Omniasherief/AUTONOMOUS_SUMO_ROBOT/code/msg1408082404-21119.jpg

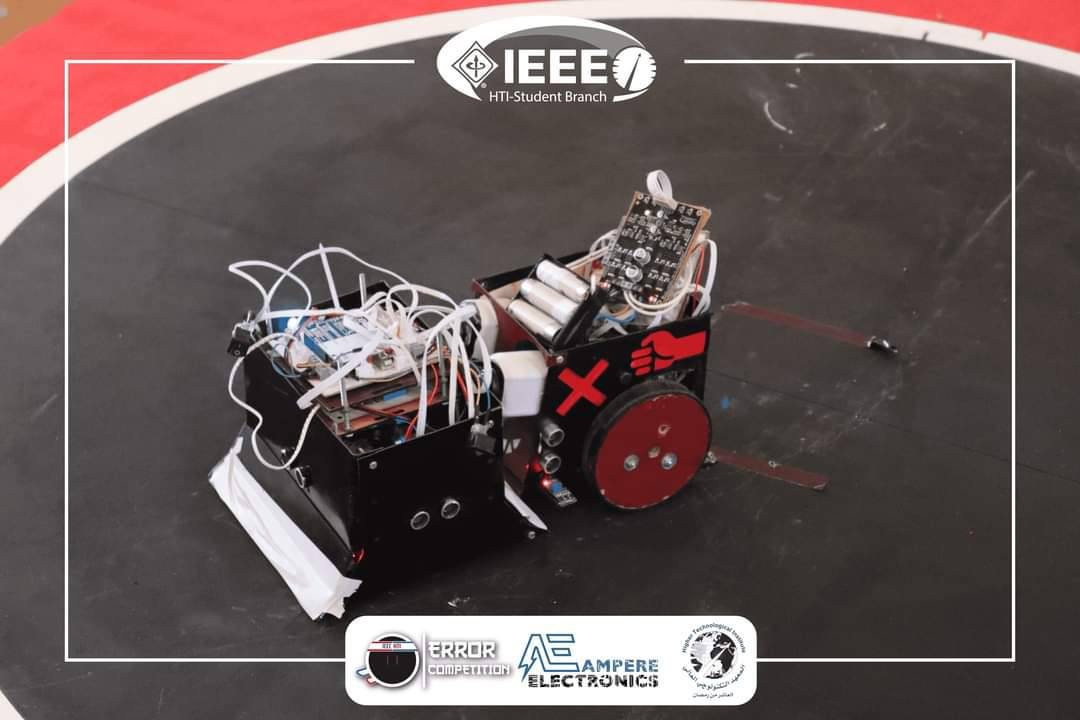
code/msg1408082404-21119.jpg
