Omniasherief/AUTONOMOUS_SUMO_ROBOT/README.md

## IEEE ERROR Competition 2023 - Team Members

We're excited to introduce our team participating in the ERROR Competition 2023!

**Software Development**

* Omnia Sherief
* Islam Elnaggar

**Hardware Engineering**

* Hamdy Saeed
* Ahmed Ibrahim

**Mechanical Engineering**

* Tasneem Abdallah
* Ahmed
