Omniasherief/AUTONOMOUS_SUMO_ROBOT/Hardware/Sumo_hardware.DOCX

1 – power circuit

We will need to take 24 volt from the batteries then we will control that voltage to be suitable for our needs
we would have a 9 volt output for the microcontroller, and we will have 5 volt outputs nut the number of these outputs depends on the number of sensors that the software members decided to have , and we would have 24 volt outputs too for the motor itself .

I recommend using buck converter to have fixed and controlled current which is more efficient for the Arduino

Components list:

Price for each | Number | The component
20 (mechatronx) | 6 | 3.3V li battery (used)
15(Mechatronx) | 2 | Battery holder 3 cells
30 (Lamba) | 1 | Mini 360 DC-DC 1.8A Buck Converter Step Down Module
2.25 (Lamba) | 5 | T-block 2pins

2 – motor driver

In the motor driver circuit, we would control the direction of the motors, depending on the motors which we have, we won't need to control the velocity because they are 22 RPM which would make it not speed, so we would keep the velocity fixed at its maximum speed.

I recommend making this circuit based on relays, because we won't need to change the velocity of the motors, also we won't need the speed of response of something like the H-Bridge

We would have 2 circuits each one for 2 wheels, one for the right wheels and the other one for the left wheels.

We will have a signal from the Arduino pins to control the direction of the motors, and there will be 24V from the batteries to supply the motors itself

Components List

Price for each | number | Component
8 (labma) | 4 | Relay 5V 10A
1 (lamba) | 4 | 2n2222
(lamba)2.25 | 1 | T- blocks
(Lamba)4 | 4 | Optocoupler pc817
0.3 (lamba) | 4 | Resistor 10k
0.3 (lamba) | 4 | Resistor 220

3 – Control circuit
This circuit will include the Arduino and the sensors, the Arduino will be fixed in pin headers, and there will be other pin headers for the Ultrasonic and IR sensors to supply them with 5V which they need.

Then we will connect the sensors with the Data Terminal Male pin connectors with female-female data cables for better connectivity.

(lamba)6 | 4 | data cable JST female 3 pin
(lamba)1.5 | 4 | Data Terminal Male 3 Pin Connector JST
(lamba)7 | 4 | data cable JST female 4 pin
(lamba) 2 | 4 | Data Terminal Male 4 Pin Connector JST
(lamba)2.25 | 4 | T-block 2 pins
0.75 (lamba) | 2 | data Terminal Male 2 Pin Connector JST
2.5 (lamba) | 2 | data cable JST female 2 pin 20 cm
0.35 | 1 | LED 3MM (Blue)
0.35 | 1 | LED 3MM (red)
0.3 | 2 | 220 resistor

Components list:

Extras

Price for each | Number | The component
75 (lamba) | 1 | PCB single layer board 30*20
5 | 3 | A4 glossy paper
20 | 2 | 1 day at a maker space for tools and fabrication

Total expected price = 455 LE

(It might vary depending on general needs and changes)
