Omniasherief/AUTONOMOUS_SUMO_ROBOT/Hardware/sumoideas.RTF

4 Incline parts
ADVANTAGES: It would be hard for the other robot to push ours
DISADV: if it's not touching the ground, we would be an easy goal
Overview: The speed isn't an advantage with our sources , so we can make it harder to attack us with 4 incline parts , with our high torque motors it would be an advantage for us , this is from the defense point , in case we attacking , it would be easier because we have an incline part in case we are going forward , and the same is well if we are going back

(we can discuss about the shape of the incline parts)
