Omniasherief/AUTONOMOUS_SUMO_ROBOT/Mechanical/Mechanical design.pdf

Mechanical design

Proposed designs:

1

st:

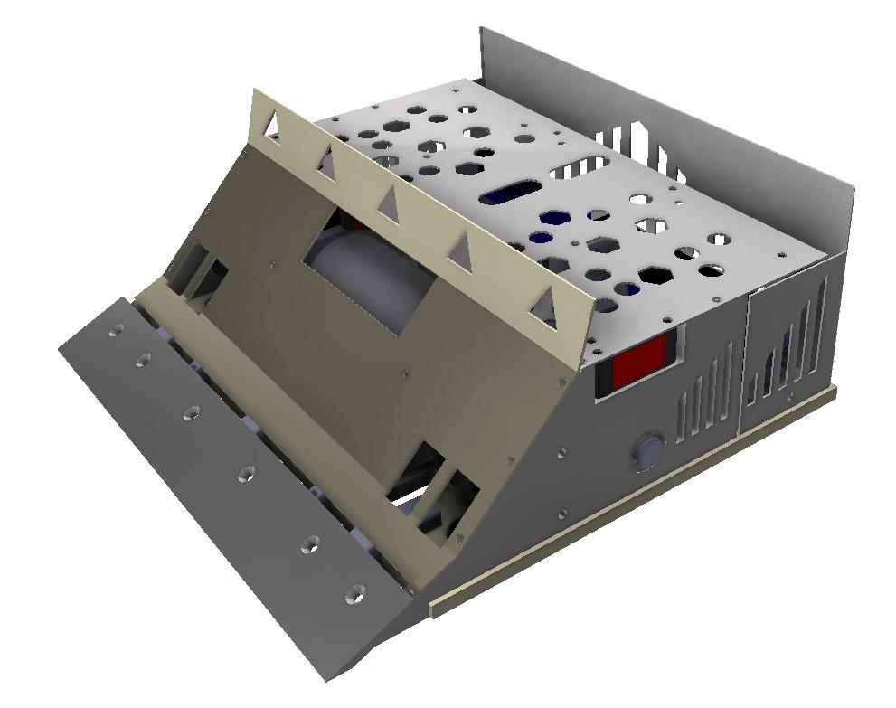
[picture p2: figure]

2

nd:

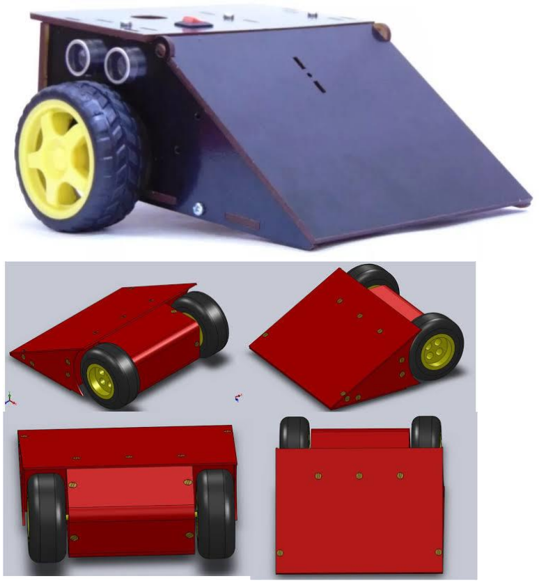
[picture p3: figure]

3

rd :

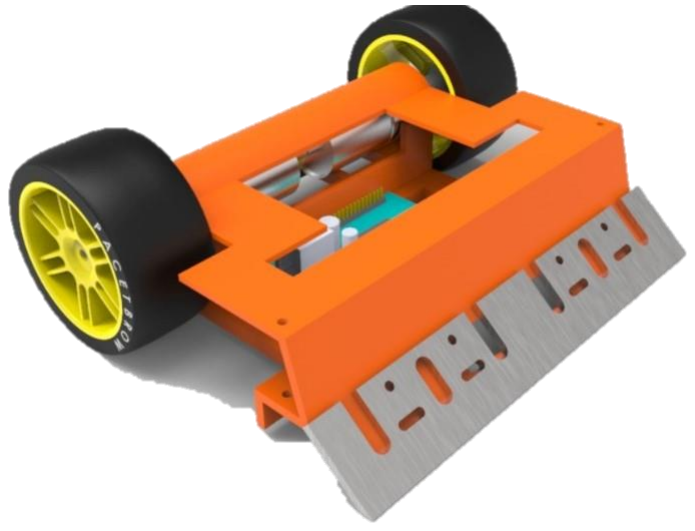
[picture p4: figure]

4

Th:

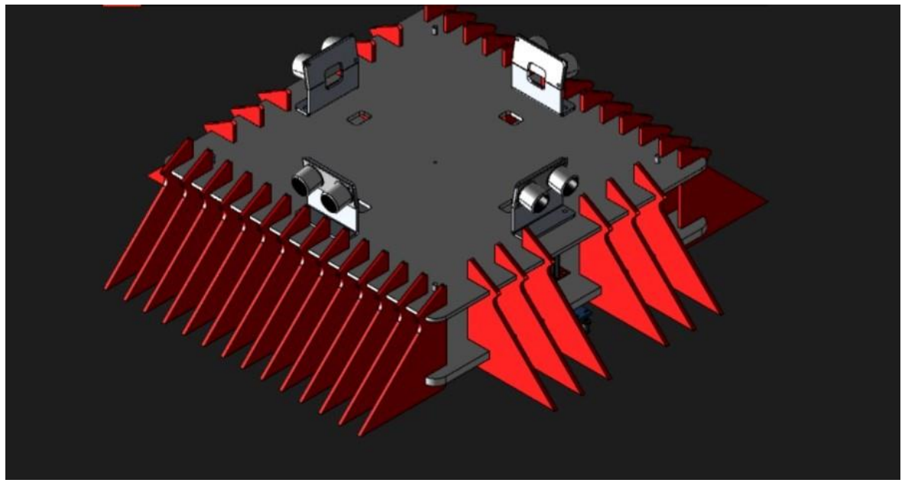
[picture p5: figure]

5

Th:

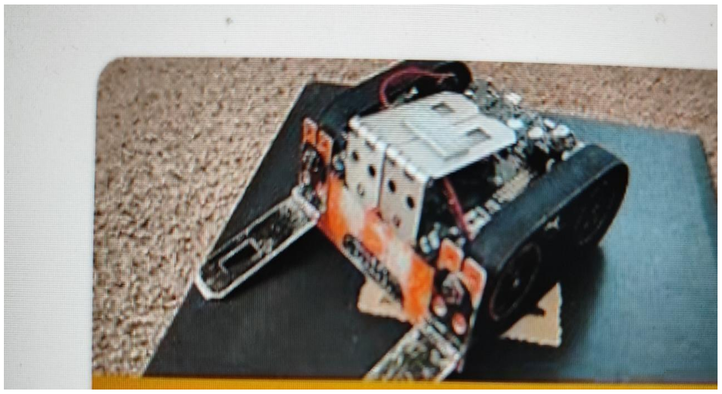
[picture p6: figure]

Note:

- سيتم اسبتدال المسامير بمفصالت للغطاء وذلك لسرعة وسهولة الفك والتركيب من اجل الصيانه اثناء المسابقة
Cost | -

هنستخدم سمك الصاج 2 مم

سعر الصاج / كج : 90

سعر التنايه : 10
لو في اي عمليه تانيه هتتعمل زي اللحام مثال ف مش عارفين سعرها
