Omniasherief/AUTONOMOUS_SUMO_ROBOT/Software/Component_v2.pdf

# SOFTWARE COMPONENT

1. Arduino Uno :360LE before sale :385LE (LAMPA TRONICS)

Another option: Arduino Uno SMD 250LE before sale:330LE

(LAMPA TRONICS)

2. Ultra sonic :40LE before sale :50 LE (LAMPA TRONICS)
3. IR sensor:25LE before sale :37LE
(LAMPA TRONICS)
4. Servo(optional):depends on strategy: 85LE (LAMPA TRONICS)
5. Battery 9V Westinghouse : 20.00 EGP (MECHATRONICS)
6. 4Pcs Battery AA 1.5V (Westinghouse) : EGP15.00 (LAMPA TRONICS)
7. AA Battery Holder 4 Cell : 8.00 EGP (MECHATRONICS)
8. Connecting Jumper Wires
9. For Bread Board & Arduino (65 Wire) 22AW : EGP30.00 (LAMPA TRONICS)
