Omniasherief/AUTONOMOUS_SUMO_ROBOT/Software/SOFT_FEEDBACK.pdf

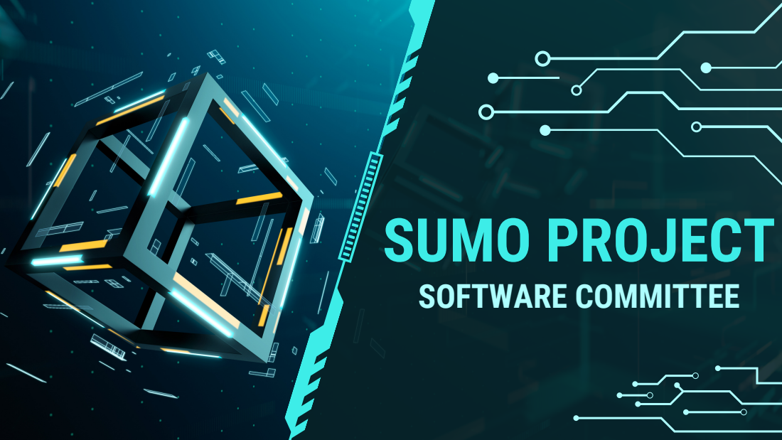
[picture p7: page 1]
SUMO PROJECT; SOFTWARE COMMITTEE

# Table Of Content

### Strategy

### Mechanical Related Issues

### Coding Challenges

### Testing Challenges

### Hardware Related Issues

Since we can't move at high speeds, our strategy tends to be basic, simple, and efficient. Basically, we let the robot move forward, then turn right 45 degrees, and finally turn left 90 degrees to position itself 45 degrees away from the starting position. This allows us to cover the blind area effectively. Of course, we made sure to check the ultrasonic sensors after every move until the enemy enters their range. Once the enemy is within range, the robot starts moving towards it, attempting to push it out. The IR sensors keep the robot inside the ring until the enemy is closer than 10cm. At that point, the robot gives priority to the fight.

# Strategy

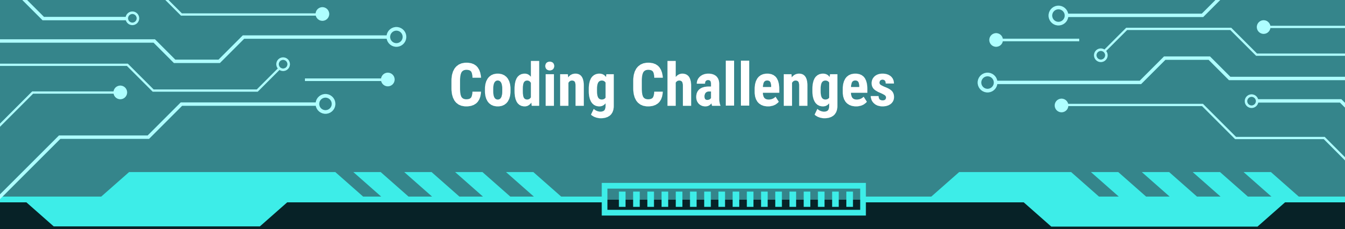
[picture p8: figure]
Coding Challenges
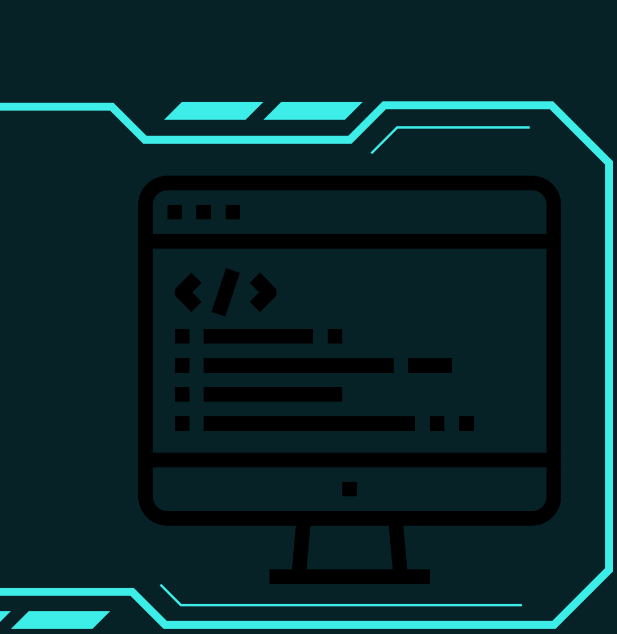
[picture p9: figure]

These are some challenges we had during the coding process:

Integrating and calibrating sensors like ultrasonic sensors
and infrared sensors.
Implementing precise and responsive motion control to navigate the robot within the sumo ring while maintaining stability. Developing an effective strategy for the robot to identify
the opponent, analyze the situation, and make decisions. Identifying and fixing software bugs, logic errors, or sensor calibration issues.

# Hardware Related Issues

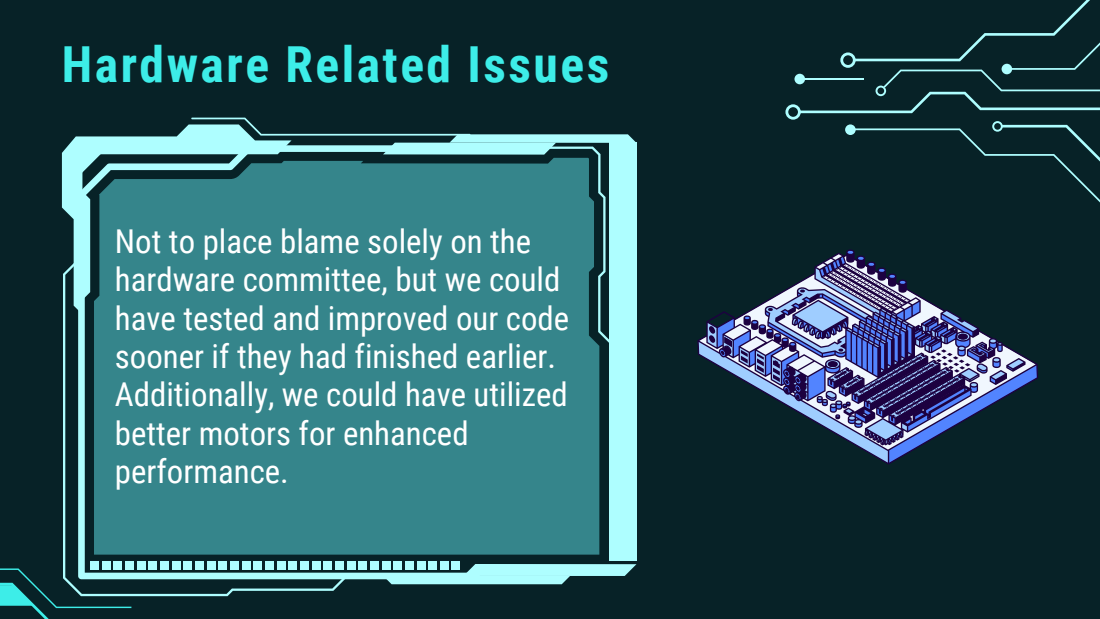
[picture p10: page 5]

Not to place blame solely on the
hardware committee, but we could
have tested and improved our code
sooner if they had finished earlier.
Additionally, we could have utilized
better motors for enhanced
performance.

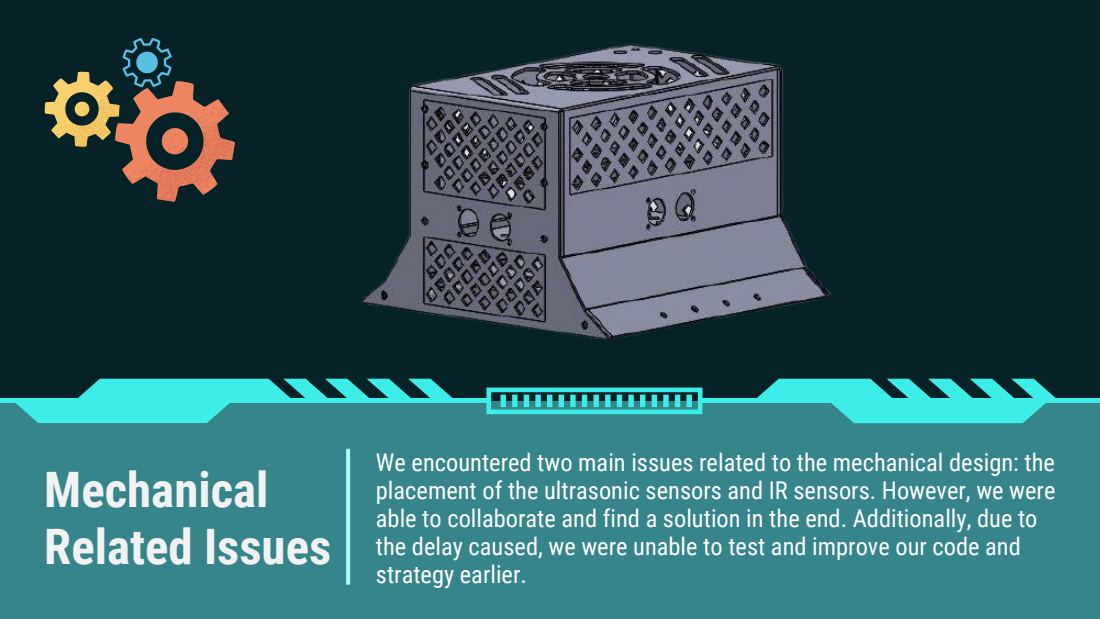
[picture p11: page 6]
Mechanical Related Issues

We encountered two main issues related to the mechanical design: the
placement of the ultrasonic sensors and IR sensors. However, we were
able to collaborate and find a solution in the end. Additionally, due to
the delay caused, we were unable to test and improve our code and
strategy earlier.

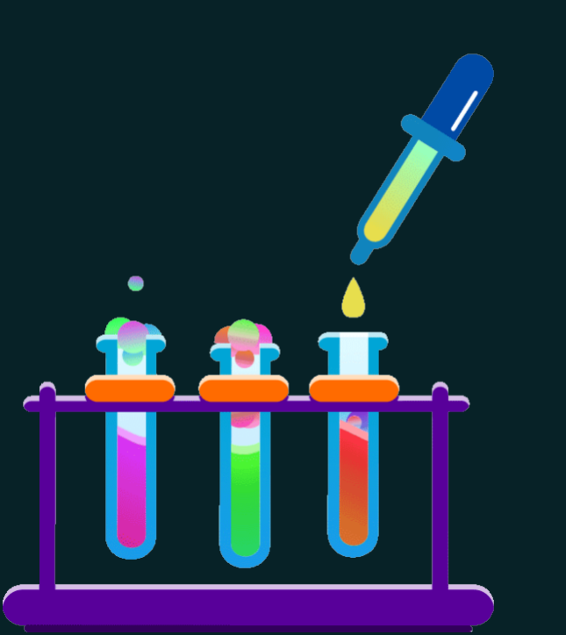
[picture p12: figure]
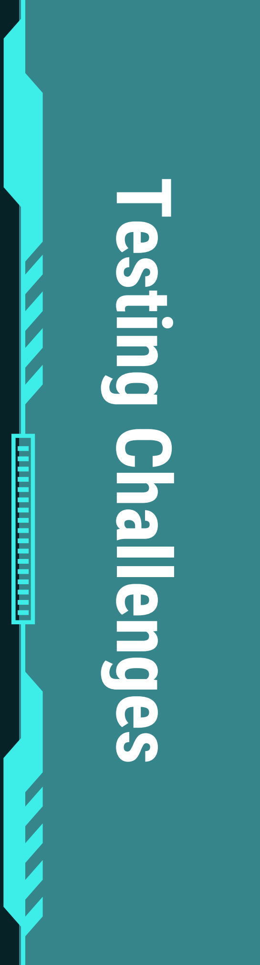
[picture p13: figure]
Testing Challenges

# Meet Our Team

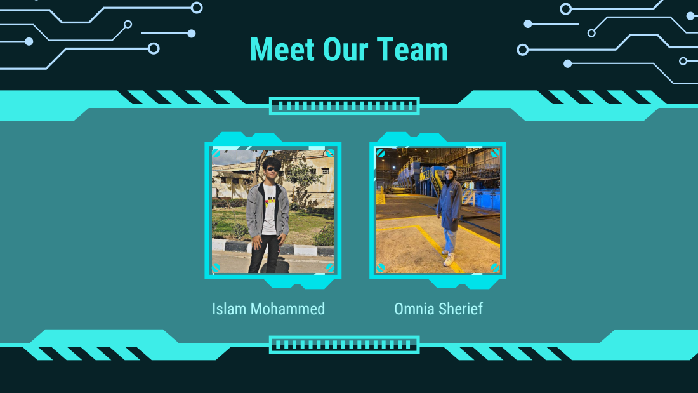
[picture p14: page 8]
Islam Mohammed; Omnia Sherief

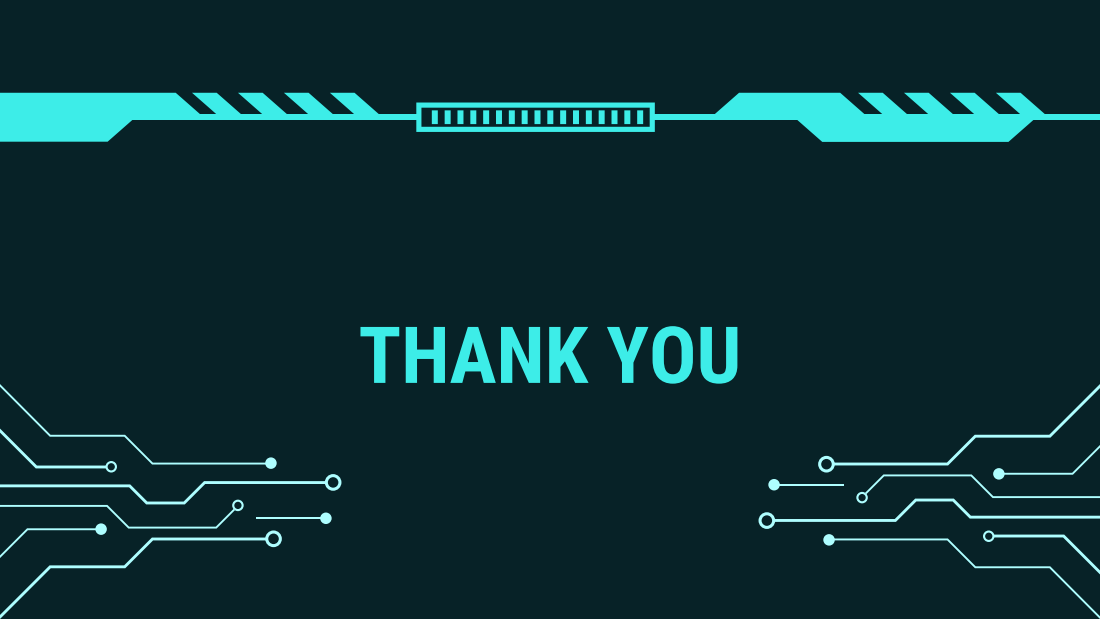
[picture p15: page 9]
THANK YOU
